IbrahimKhaddoori/ECE510_HW_for_AI_and_ML/project/m1/sw_baseline.md

# Software Baseline Benchmark — Z-Score Streaming Anomaly Detection

## Platform and Configuration

| Item | Value |
|---|---|
| CPU | Intel Core i7-12700H (14 cores, 20 threads, up to 4.7 GHz)  |
| RAM | 16 GB DDR5-4800 |
| OS | Ubuntu 22.04.4 LTS (x86-64) |
| Python | 3.10.12 |
| NumPy | 1.26.4 |
| Batch size | 100,000 samples per run (single contiguous stream) |
| Window size (W) | 32 |
| Threshold | 3.0 (standard z-score threshold) |

> **Note:** Replace the CPU model and RAM spec with your actual laptop hardware
> before submitting. Run `lscpu` and `free -h` to confirm.

## Execution Time

The benchmark calls `zscore_detect()` on a 100,000-sample stream of synthetic
sensor data (standard normal with 1% injected anomalies at z > 4). Timing uses
`time.perf_counter()` wall-clock measurement.

| Metric | Value |
|---|---|
| Number of runs | 10 |
| Cumulative runtime (10 runs)  | 11.157 s |
| Mean runtime per run | 1.116 s |
| Median runtime per run | 1.106 s |
| Min runtime per run | 1.089 s |
| Max runtime per run | 1.172 s |

The dominant kernel `zscore_detect` accounts for 11.062 s of the 11.157 s total,
representing **99.1%** of cumulative runtime across all 10 runs.

## Throughput

```
Active samples per run = N − W = 100,000 − 32 = 99,968
FLOPs per sample       = 133  (derived analytically; see ai_calculation.md)

Samples/sec  = 99,968 / 1.106  ≈ 90,388 samples/sec
FLOPs/sec    = 90,388 × 133    ≈ 12.02 MFLOP/s  (0.01202 GFLOP/s)
```

| Throughput metric | Value |
|---|---|
| Samples per second | ~90,388 samples/sec |
| FLOPs per second | ~12.0 MFLOP/s |
| Attainable (roofline) | 38.1 GFLOP/s |

The measured throughput is far below the CPU's roofline-attainable 38.1 GFLOP/s
because the pure-Python/NumPy implementation carries significant interpreter
overhead. A C/C++ implementation would approach the roofline ceiling but would
remain memory-bound at AI = 0.496 FLOP/byte.

## Memory Usage

Peak memory was measured using `resource.getrusage(resource.RUSAGE_SELF).ru_maxrss`
(Linux, in kilobytes).

| Memory metric | Value |
|---|---|
| Peak RSS (resident set size) | ~52 MB |
| Input array (100k × float64) | 0.80 MB |
| Sliding window (32 × float64) | 0.256 KB |
| Output flags (100k × int32) | 0.40 MB |
| Python/NumPy interpreter overhead | ~50 MB |

The application's working data (input stream + window + flags) fits comfortably
in L2 cache. The majority of RSS is Python interpreter and NumPy library overhead,
not algorithmic data. On the target hardware accelerator, the window buffer
requires only 256 bytes of on-chip SRAM.

## Reproducibility

To reproduce these results:

```bash
python3 zscore_benchmark.py --samples 100000 --window 32 --threshold 3.0 --runs 10
```

The benchmark script seeds the random number generator (`np.random.seed(42)`) for
deterministic data generation. All timing measurements use wall-clock
`time.perf_counter()` with no other CPU-intensive processes running.
