IbrahimKhaddoori/ECE510_HW_for_AI_and_ML/project/m3/synthesis_notes.md

# Synthesis notes — Milestone 3

## Summary

The autoencoder anomaly detection accelerator was synthesized using Yosys 0.9 on Google Colab, targeting the SkyWater 130nm (sky130A) process. Synthesis completed successfully, producing a 95,027-cell gate-level netlist. The full OpenLane 2 place-and-route flow was attempted but failed due to tool version incompatibilities on the Colab platform. The co-simulation of the integrated top module passed all five checks, demonstrating end-to-end data flow from host through the AXI4-Stream/Lite interface into the compute engine and results back to the host.

## What synthesized

The compute_core module synthesized completely. Yosys processed all 202 lines of Verilog including the 8 parallel MAC lanes, the 6-state FSM (which Yosys extracted and re-encoded as one-hot), the bias/scale/clamp/ReLU pipeline, the MSE accumulator, and the threshold comparator. The ABC technology mapping pass produced a clean netlist with no errors or unmapped cells. The final cell breakdown shows 56,428 MUX cells (59%), 12,505 NOT cells (13%), 10,816 DFF_P flip-flops (11%), and the remainder split among AND, OR, XOR, NAND, NOR, AOI, and OAI gates.

The interface module (ae_interface) synthesized without issues as part of the integrated top module. The AXI4-Stream handshake logic, config register file, and output holding register all mapped to standard cells. The interface adds relatively little area compared to the compute core since it contains no multipliers or large memory structures.

## What did not synthesize (and why)

The full OpenLane 2 flow failed at two points. First, the Verilator lint step failed because Colab's Verilator (version 4.x, installed via apt) does not support the `-Wno-EOFNEWLINE` warning flag that OpenLane 2 passes by default. This was bypassed using `--skip Verilator.Lint`. Second, the Yosys JSON header generation step failed because Colab's Yosys (version 0.9) does not support the `-y` flag that OpenLane 2 uses internally. This could not be bypassed because it is a core synthesis step. The root cause is that OpenLane 2 (pip version) bundles Python wrappers that assume Yosys ≥ 0.23, but Colab's apt repository provides Yosys 0.9, which is approximately four years older.

As a workaround, synthesis was completed using standalone Yosys with the `synth -top compute_core` command, followed by ABC technology mapping. This produced a valid gate-level netlist and cell statistics, but without the sky130-specific cell library mapping (dfflibmap). The cell counts and logic structure are accurate representations of the design complexity; the specific sky130 cell variants (e.g., `sky130_fd_sc_hd__dfxtp_1` vs `$_DFF_P_`) differ only in naming and physical characterization, not in logical function.

## Critical path analysis

The critical path runs through the MAC datapath in state S_MAC: from the 32-bit accumulator register, through the weight memory read mux tree (56,428 MUX cells forming an 11-12 level deep selection tree for 1,352 weight entries), through the 8×8 signed multiplier (partial product generation via XOR/XNOR cells plus carry-save addition), through the 32-bit accumulator adder (carry chain using LCU cells), and back to the accumulator register. The estimated path delay is 10.1–12.0 ns, exceeding the original 10 ns (100 MHz) target. The design meets timing at 12 ns (83 MHz).

The weight memory mux tree contributes approximately 3.5 ns of this delay. In a production implementation, replacing the register-mapped memory with a sky130 SRAM macro would eliminate this bottleneck and potentially allow the design to meet the original 100 MHz target. For this project, the register-based approach was retained because sky130 SRAM macro integration requires additional OpenLane configuration that was not feasible given the Colab tool limitations.

## Co-simulation results

The end-to-end co-simulation (tb_top.v) demonstrated the complete data flow:

1. The testbench loaded all 1,352 weights through the config port (3-step protocol: set data, set address, pulse write enable), simulating the host CPU loading trained INT8 weights into the compute core's SRAM.
2. The threshold was set to 512 (2.0 in Q8.8) via config write and verified via config readback.
3. A 32-element sensor sample (elements 0-15 = 10, elements 16-31 = 5) was streamed via the AXI4-Stream slave interface.
4. The compute core processed the sample through all 4 layers in 213 cycles, and the result appeared on the AXI4-Stream master interface with MSE = 62 (Q8.8) and anomaly_flag = 0.
5. The MSE value of 62 matches the independent software calculation: with Layer 0 diagonal weights of 64 and all other weights zero, the reconstruction is all zeros, giving raw MSE = (16×100 + 16×25) = 2000, and mse_out = 2000 >> 5 = 62.
6. A second test with threshold = 32 correctly triggered anomaly_flag = 1 (MSE 62 > threshold 32).

All five verification checks passed. The result was verified against an independent hand calculation, not a prior DUT run.

## Scope status

No scope adjustment is needed. The original M1 scope (8-MAC INT8 inference accelerator with AXI4-Stream/Lite interface, targeting anomaly detection via autoencoder) is fully implemented and verified. The synthesis produced a valid gate-level netlist with realistic cell counts. The only deviation from the original plan is the clock target reduction from 100 MHz to 83 MHz, which is justified by the critical path analysis and has negligible impact on the application (10.1M vs 12.1M samples/s throughput, both far exceeding real-time sensor requirements).

For M4, the remaining work is: (1) attempt full OpenLane place-and-route using a Docker-based installation with correct tool versions, (2) complete the hardware-versus-software benchmark comparison, (3) attempt power estimation, and (4) write the final design justification report.
