IbrahimKhaddoori/ECE510_HW_for_AI_and_ML/codefest/cf09/cman_roofline_sketch.pdf

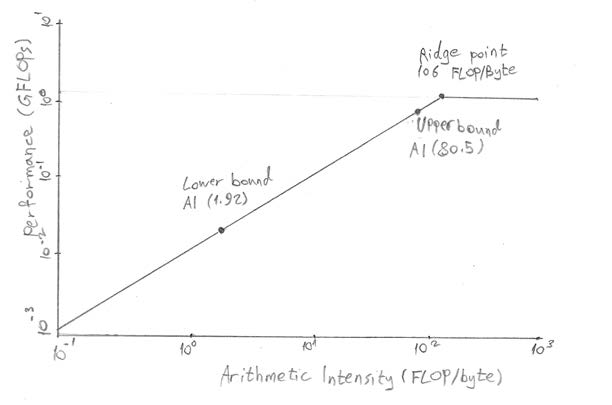
[picture p5: page 1]
