IbrahimKhaddoori/ECE510_HW_for_AI_and_ML/codefest/cf09/cman_ai_analysis.pdf

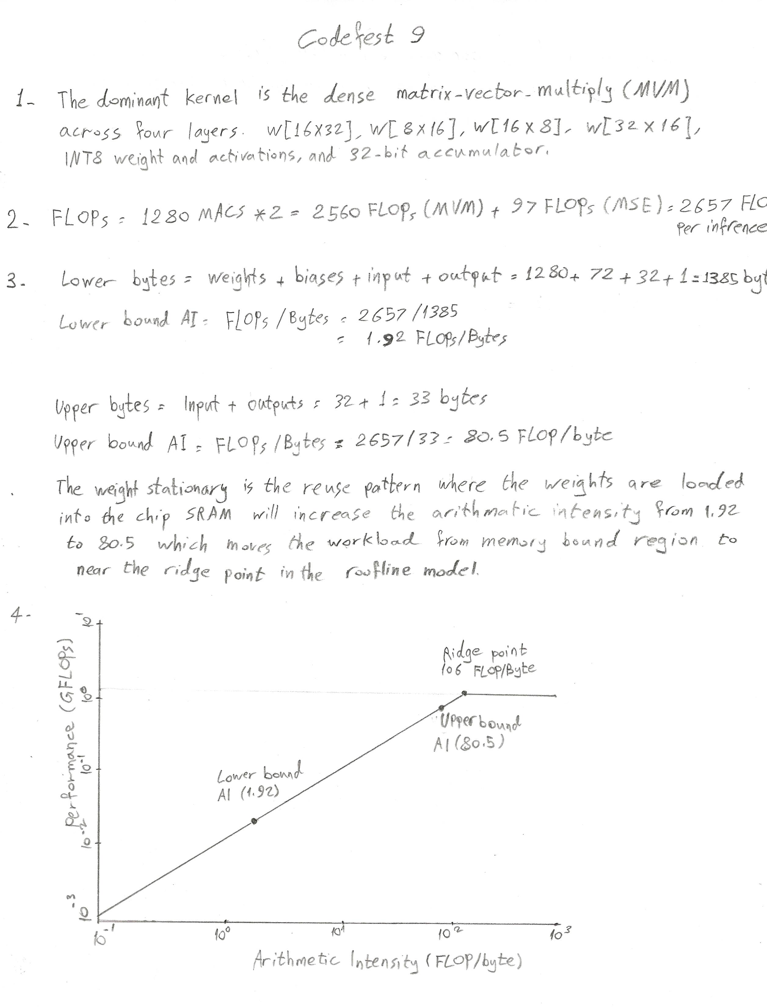
[picture p6: page 1]
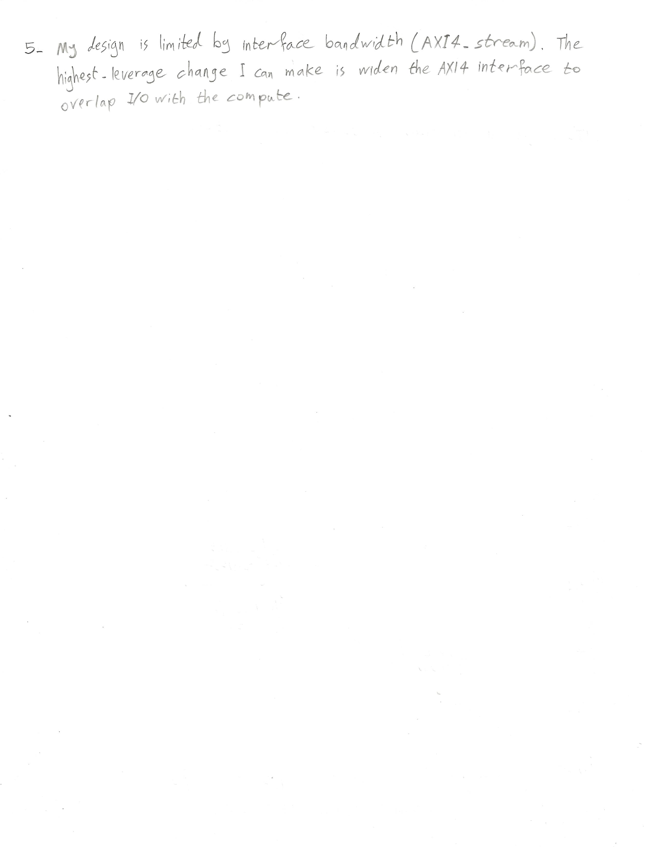
[picture p7: page 2]
