IbrahimKhaddoori/ECE510_HW_for_AI_and_ML/codefest/cf08/cman_aer_analysis.pdf

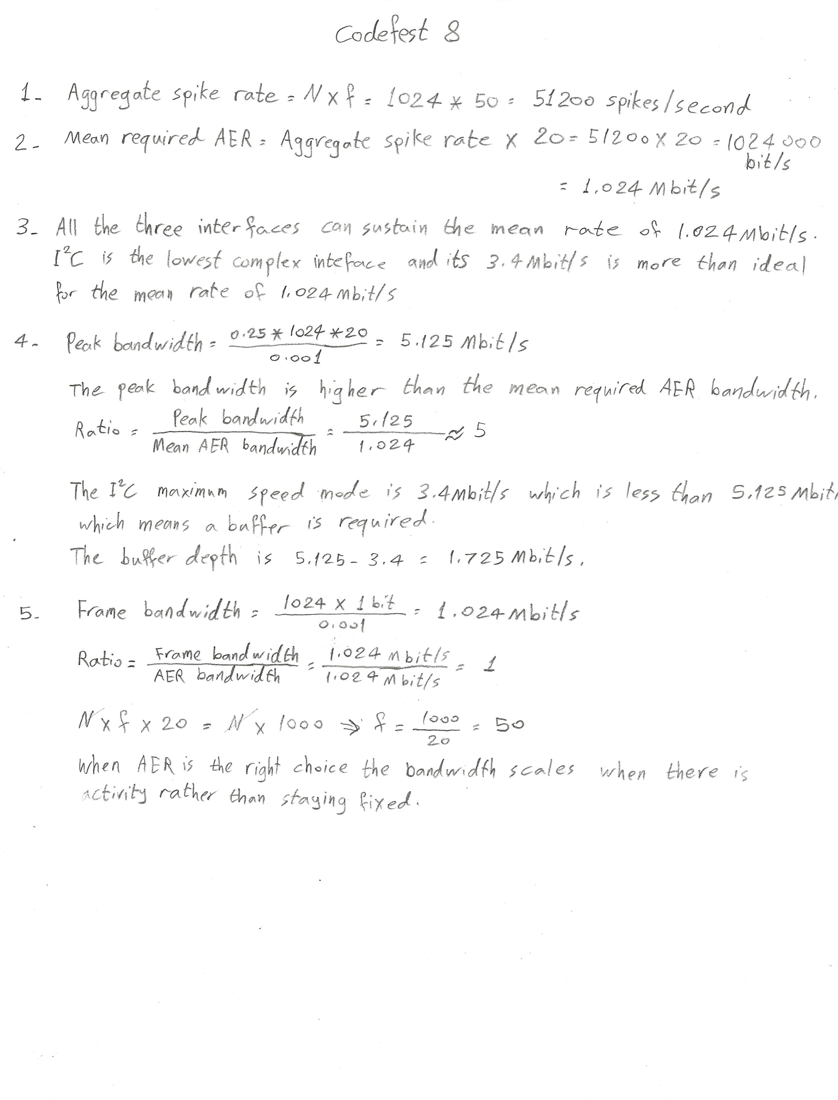
[picture p8: page 1]
