IbrahimKhaddoori/ECE510_HW_for_AI_and_ML/codefest/cf07/cman_sparsity_analysis.pdf

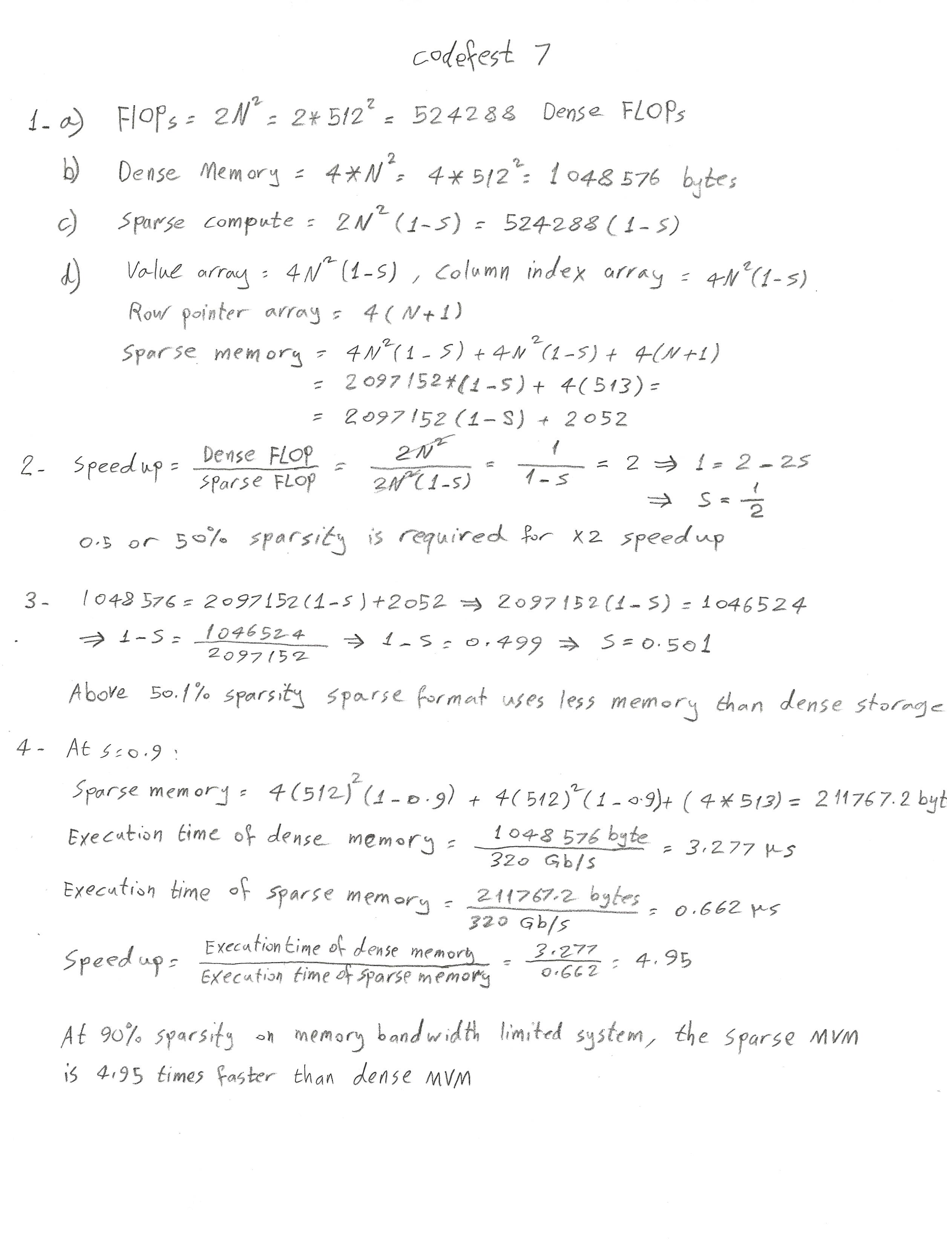
[picture p9: page 1]
