IbrahimKhaddoori/ECE510_HW_for_AI_and_ML/codefest/cf06/cman_sneak_path.pdf

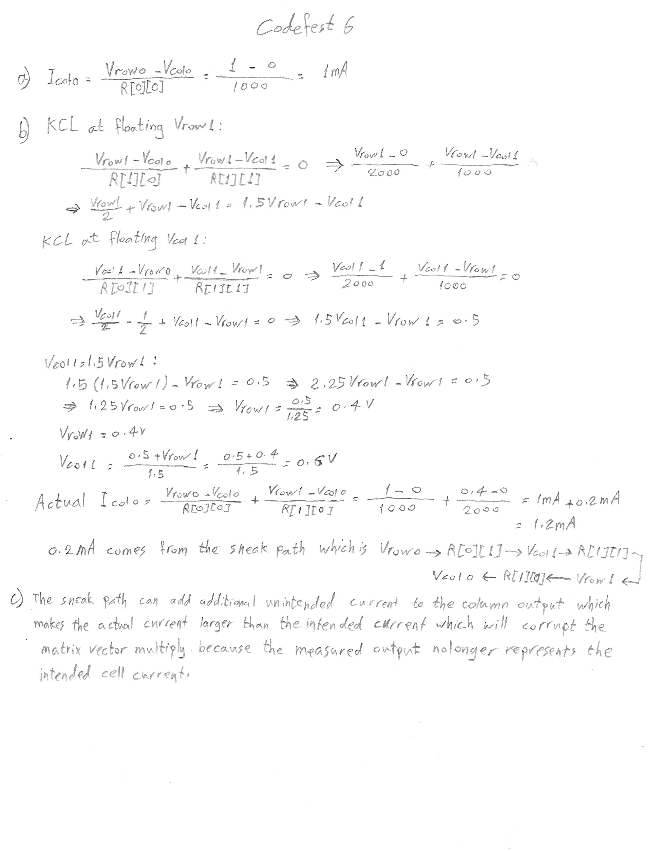
[picture p10: page 1]
