IbrahimKhaddoori/ECE510_HW_for_AI_and_ML/codefest/cf05/cman_systolic_trace.pdf

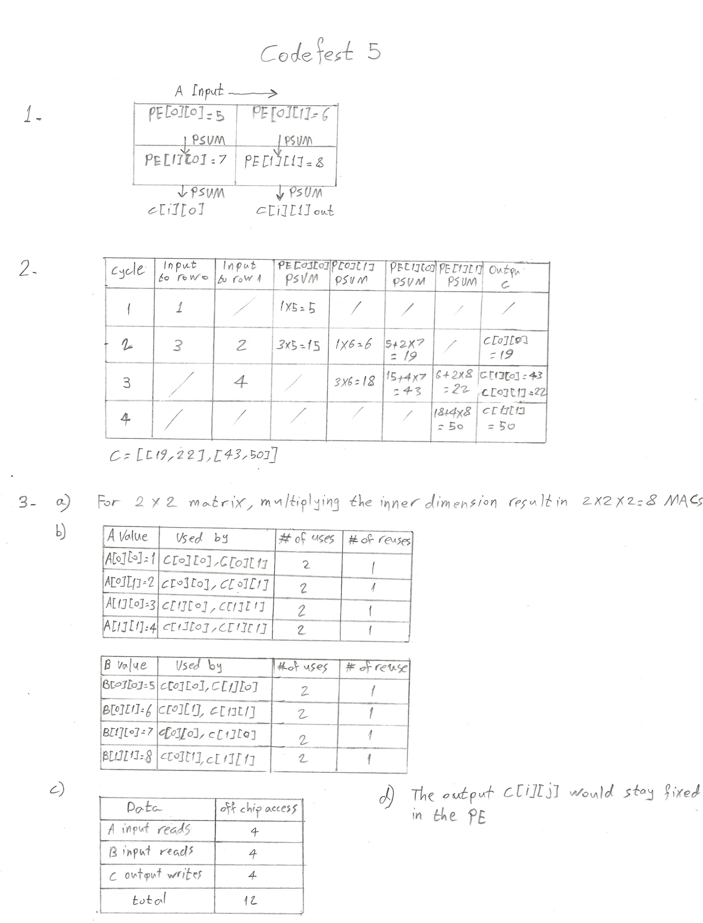
[picture p11: page 1]
