IbrahimKhaddoori/ECE510_HW_for_AI_and_ML/codefest/cf04/cman_quantization.pdf

## CF04 : Cman Quantization

Original Weight Matrix W (FP32):

| Col 0 | Col 1 | Col 2 | Col 3
Row 0 | 0.85 | -1.20 | 0.34 | 2.10
Row 1 | -0.07 | 0.91 | -1.88 | 0.12
Row 2 | 1.55 | 0.03 | -0.44 | -2.31
Row 3 | -0.18 | 1.03 | 0.77 | 0.55

### 1) Scale Factor S

Formula: S = max(|W|) / 127

maximum(|W|) = 2.31 at position (2,3)

S = 2.31 / 127 = 0.018

### 2) Quantize

W_q = round(W / S), clamped to [−128, 127]:

Col 0 Col 1 Col 2 Col 3

Row 0 47 | -66 | 19 | 115
Row 1 -4 | 50 | -103 | 7
Row 2 85 | 2 | -24 | -127
Row 3 -10 | 57 | 42 | 30

### 3) Dequantize

W_deq = W_q x S:

Col 0 | Col 1 | Col 2 | Col 3

Row 0 0.8549 -1.2005 0.3456 2.0917

Row 1 -0.0728 0.9094 -1.8735 0.1273

Row 2 1.5461 0.0364 -0.4365 -2.3100

Row 3 -0.1819 1.0368 0.7639 0.5457

### 4) Error Analysis

Per-element absolute error |W − W_deq|:

Col 0 | Col 1 | Col 2 | Col 3

Row 0 0.004882 0.000472 0.005591 0.008268

Row 1 0.002756 0.000551 0.006536 0.007323

Row 2 0.003937 0.006378 0.003465 0

Row 3 0.001890 0.006772 0.006063 0.004331

Largest error: 0.008268 at position (0,3) W = 2.10, W_deq = 2.0917

Mean Absolute Error (MAE): (0.004882 + 0.000472 + 0.005591 + 0.008268 + 0.002756 + 0.000551 + 0.006536 + 0.007323 + 0.003937 + 0.006378 + 0.003465 + 0 + 0.001890 + 0.006772 + 0.006063 + 0.004331) / 16 = 0.004326

### 5) Bad Scale Experiment

With S_bad = 0.01, clamped to [−1.28, 1.27].

Quantized and clamping to [−128, 127]):

Col 0 Col 1 Col 2 Col 3

Row 0 85 | -120 | 34 | 127
Row 1 -7 | 91 | -128 | 12
Row 2 127 | 3 | -44 | -128
Row 3 -18 | 103 | 77 | 55

Dequantized:

Col 0 Col 1 Col 2 Col 3

Row 0 0.85 | -1.20 0.34 | 1.27
Row 1 -0.07 0.91 | -1.28 0.12
Row 2 1.27 | 0.03 | -0.44 -1.28
Row 3 -0.18 1.03 | 0.77 | 0.55

MAE_bad = (0.83 + 0.28 + 0.6 + 1.03) / 16 = 0.1713

When S is too small, the quantized range will not include values with magnitude larger than 1.28 and smaller than -1.27, which make the values clamp to the INT8 boundary, causing severe clipping error on large weights that fall outside the range resulting in a large mean absolute error.
