IbrahimKhaddoori/ECE510_HW_for_AI_and_ML/codefest/cf03/cman_dram_traffic.pdf

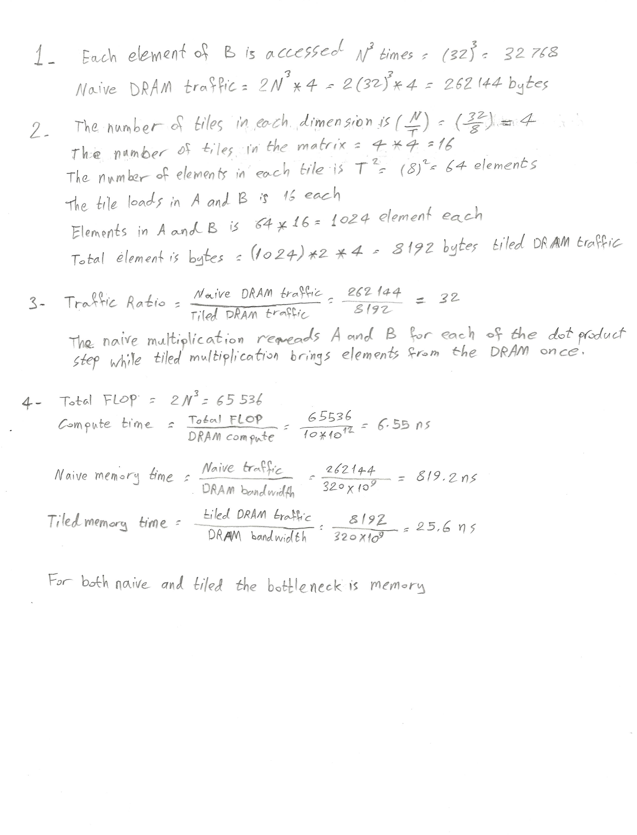
[picture p12: page 1]
