IbrahimKhaddoori/ECE510_HW_for_AI_and_ML/codefest/cf02/cman_roofline.pdf

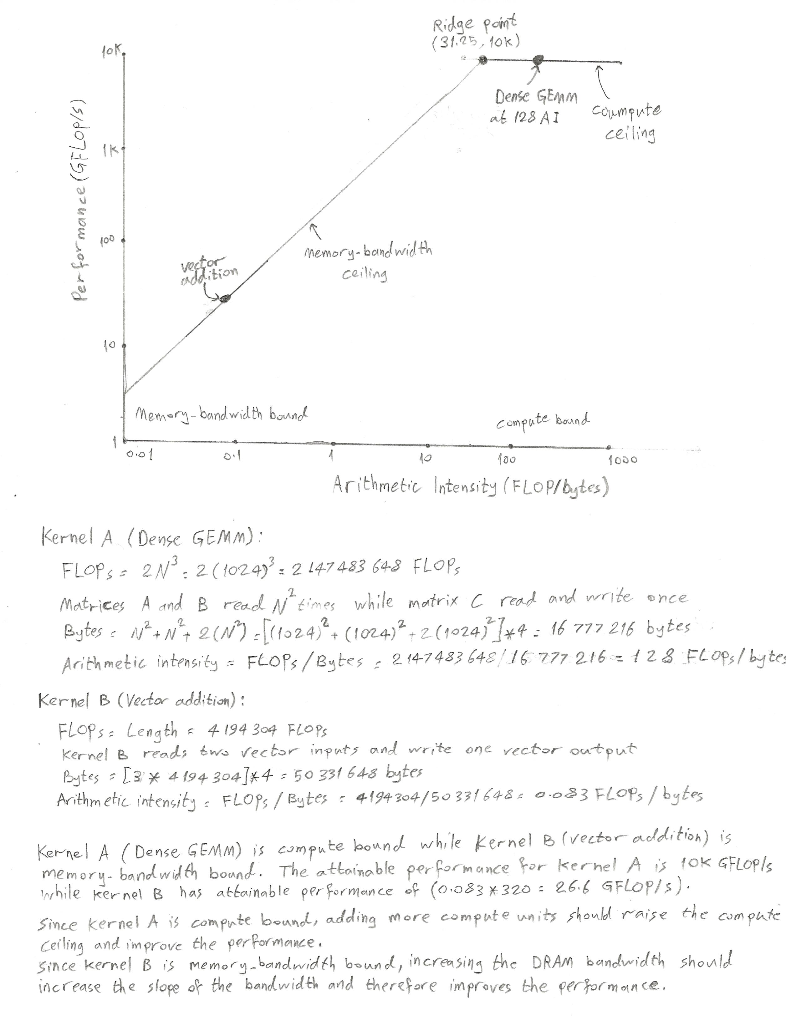
[picture p13: page 1]
