IbrahimKhaddoori/ECE510_HW_for_AI_and_ML/project/m3/synth/timing_report.txt

# Static Timing Analysis — Estimate Report
# Design: compute_core
# Clock:  clk (target period = 10.0 ns, 100 MHz)
# PDK:    sky130A (SkyWater 130nm)
# Tool:   Yosys 0.9 synthesis + manual critical path analysis
# Note:   Full STA (OpenSTA) could not run on Colab due to Yosys/OpenLane
#         version incompatibility. This report is derived from the synthesized
#         netlist structure and sky130 cell delay estimates.
# ============================================================================

Clock: clk
  Period:          10.0 ns
  Frequency:       100 MHz

# ----------------------------------------------------------------------------
# Critical Path Analysis
# ----------------------------------------------------------------------------

Path 1 (WORST CASE — Setup):
  Startpoint:  acc0[31:0]  (DFF_P, rising edge of clk)
  Endpoint:    acc0[31:0]  (DFF_P, rising edge of clk)
  Path Group:  clk
  Path Type:   max (setup)

  Description:
    The critical path runs through the MAC datapath in state S_MAC:
      1. acc register output        →  ~0.3 ns  (clk-to-Q of $_DFF_P_)
      2. weight_mem read mux tree   →  ~3.5 ns  (56,428 MUX cells, ~12 levels deep
                                                   for 1352-entry memory)
      3. 8x8 signed multiplier      →  ~2.5 ns  (XOR/AND/adder tree for
                                                   partial products, 2430 XOR +
                                                   1143 XNOR cells)
      4. 32-bit accumulator add     →  ~3.0 ns  (carry chain through 32-bit
                                                   ripple/LCU adder)
      5. MUX for state-dependent    →  ~0.5 ns  (select between MAC result
         writeback                                and other state outputs)
      6. DFF setup time             →  ~0.3 ns

  Estimated Path Delay:    ~10.1 - 12.0 ns
  Required Time:           10.0 ns (clock period) - 0.3 ns (setup) = 9.7 ns
  Estimated Worst Slack:   -0.4 to -2.3 ns  (VIOLATED)
  Estimated Max Frequency: 83 - 100 MHz

# ----------------------------------------------------------------------------
# Path 2 (MSE Datapath):
# ----------------------------------------------------------------------------

Path 2:
  Startpoint:  orig_in[*] / act_out[*]  (DFF_P)
  Endpoint:    mse_acc[31:0]            (DFF_P)

  Description:
    MSE computation in state S_MSE:
      1. Read orig_in[mse_idx] and act_out[mse_idx] from register files
      2. 9-bit subtraction (mse_diff)
      3. 18-bit squaring (mse_diff * mse_diff)
      4. 32-bit accumulate (mse_acc + mse_sq)

  Estimated Path Delay:    ~8.0 ns
  Slack:                   ~+1.7 ns (MET)

# ----------------------------------------------------------------------------
# Path 3 (Weight Address Computation):
# ----------------------------------------------------------------------------

Path 3:
  Startpoint:  cur_round / cur_layer  (DFF_PN0)
  Endpoint:    weight_mem read address (combinational to MUX select)

  Description:
    Address calculation: l_wbase + (nbase + offset) * l_in + mac_idx
    Involves two multiplications and two additions feeding the mux tree.

  Estimated Path Delay:    ~7.0 ns
  Slack:                   ~+2.7 ns (MET)

# ----------------------------------------------------------------------------
# Summary
# ----------------------------------------------------------------------------

  Worst Negative Slack (WNS):     -0.4 to -2.3 ns (estimated)
  Total Negative Slack (TNS):     -50 to -200 ns (estimated, ~80 endpoints)
  Number of Violating Paths:      ~80 (accumulator register bits)
  Number of Paths Analyzed:       ~11,902 (all flip-flop endpoints)

  Recommendation:
    - Relax clock to 12.0 ns (83 MHz) to meet timing with positive slack
    - Or pipeline the MAC: split multiply and accumulate into 2 stages
    - Weight memory mux tree is a secondary concern (contributes ~3.5 ns)
      but would be eliminated by using an SRAM macro

# ============================================================================
# Cell Area Estimates (sky130_fd_sc_hd)
# ============================================================================
#
# Cell Type          Count    Est. Area/Cell (um²)   Total Area (um²)
# $_DFF_P_           10,816   ~21.5                  ~232,544
# $_DFF_PN0_          1,085   ~26.3                  ~ 28,536
# $_MUX_             56,428   ~11.3                  ~637,636
# $_NOT_             12,505   ~ 3.8                  ~ 47,519
# $_OR_               4,081   ~ 5.1                  ~ 20,813
# $_ANDNOT_           2,738   ~ 5.1                  ~ 13,964
# $_XOR_              2,430   ~ 8.8                  ~ 21,384
# $_XNOR_             1,143   ~ 8.8                  ~ 10,058
# Other               3,801   ~ 7.0 (avg)            ~ 26,607
# ─────────────────────────────────────────────────────────────
# TOTAL              95,027                           ~1,039,061 um²
#
# Die area (config):  1400 x 1400 = 1,960,000 um²
# Core utilization:   ~53%
# ============================================================================
