IbrahimKhaddoori/ECE510_HW_for_AI_and_ML/codefest/cf02/profiling/roofline_project.png

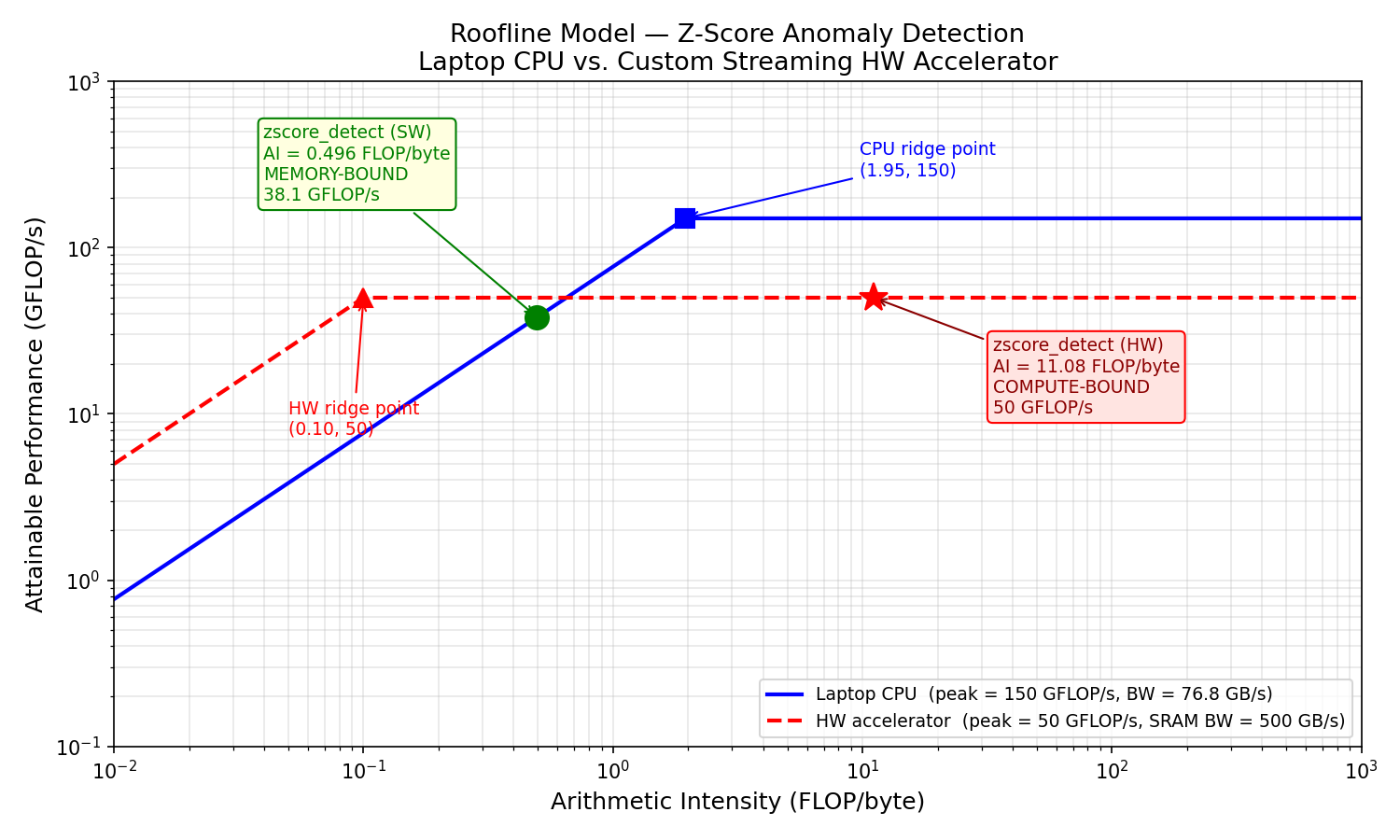
codefest/cf02/profiling/roofline_project.png
