IbrahimKhaddoori/ECE510_HW_for_AI_and_ML/codefest/cf03/profiling/gemm_roofline.png

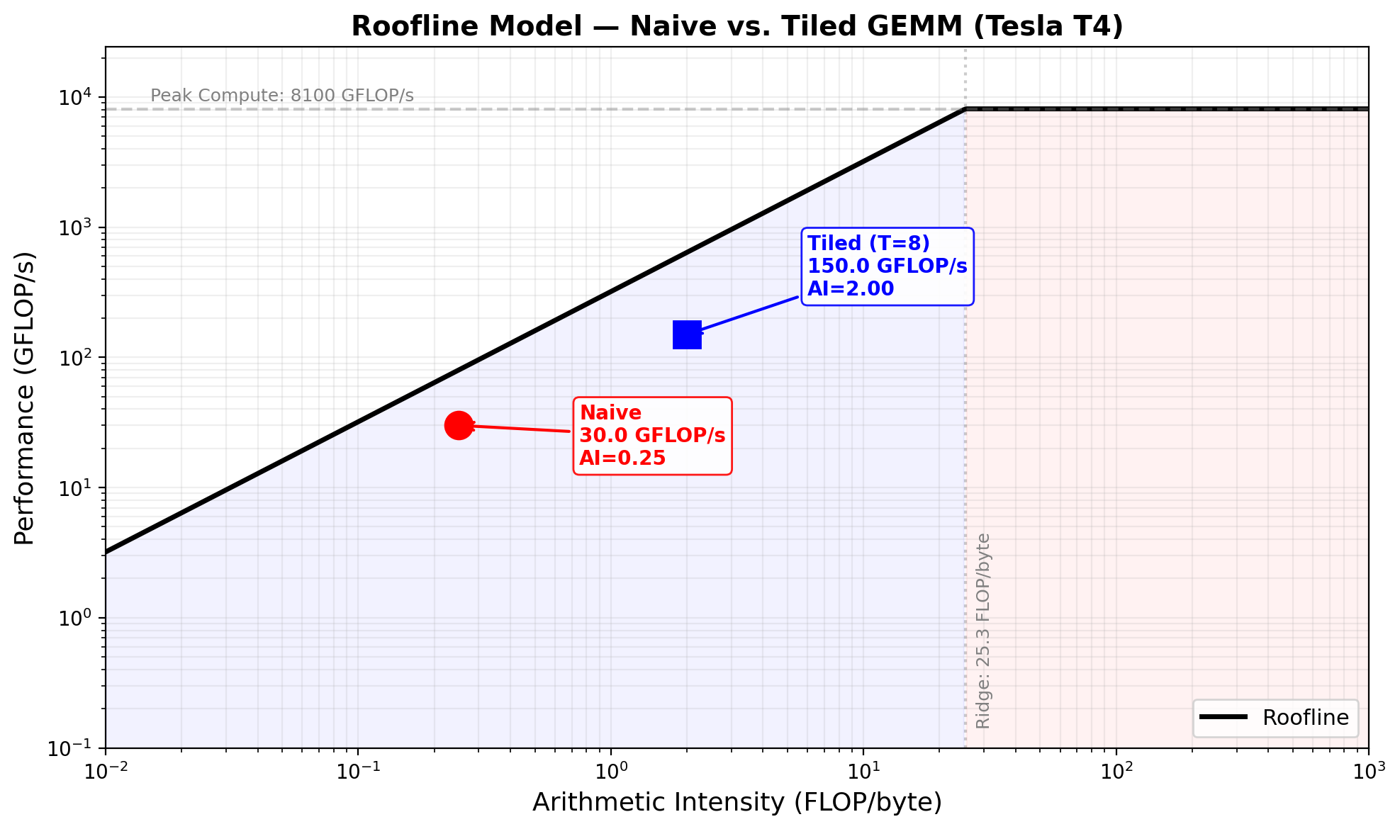
codefest/cf03/profiling/gemm_roofline.png
