IbrahimKhaddoori/ECE510_HW_for_AI_and_ML/project/algorithm_diagram.png

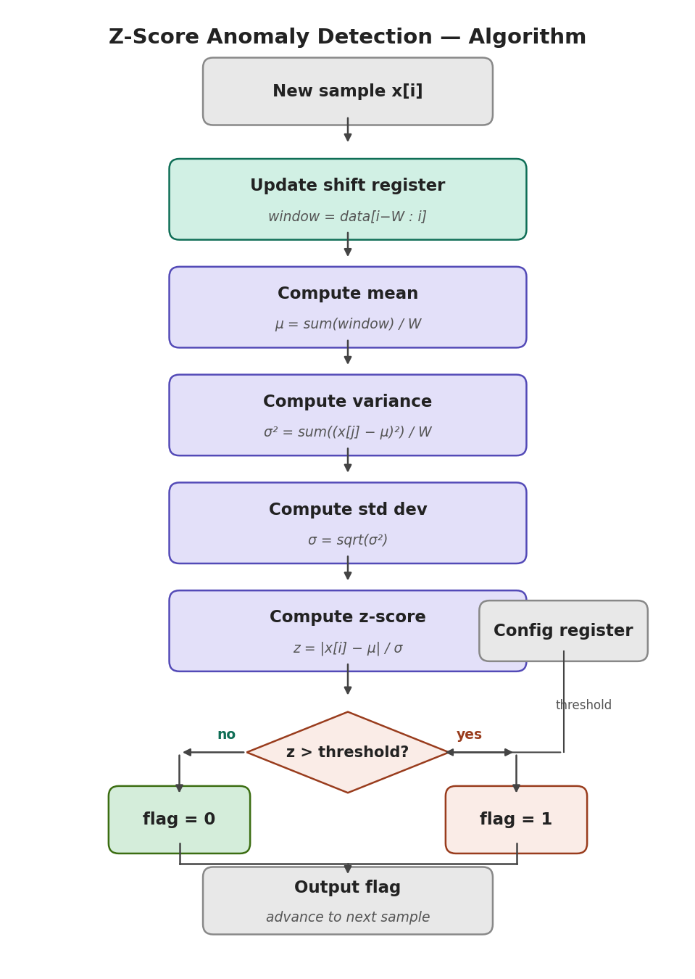
project/algorithm_diagram.png
