IbrahimKhaddoori/ECE510_HW_for_AI_and_ML/project/m1/system_diagram.png

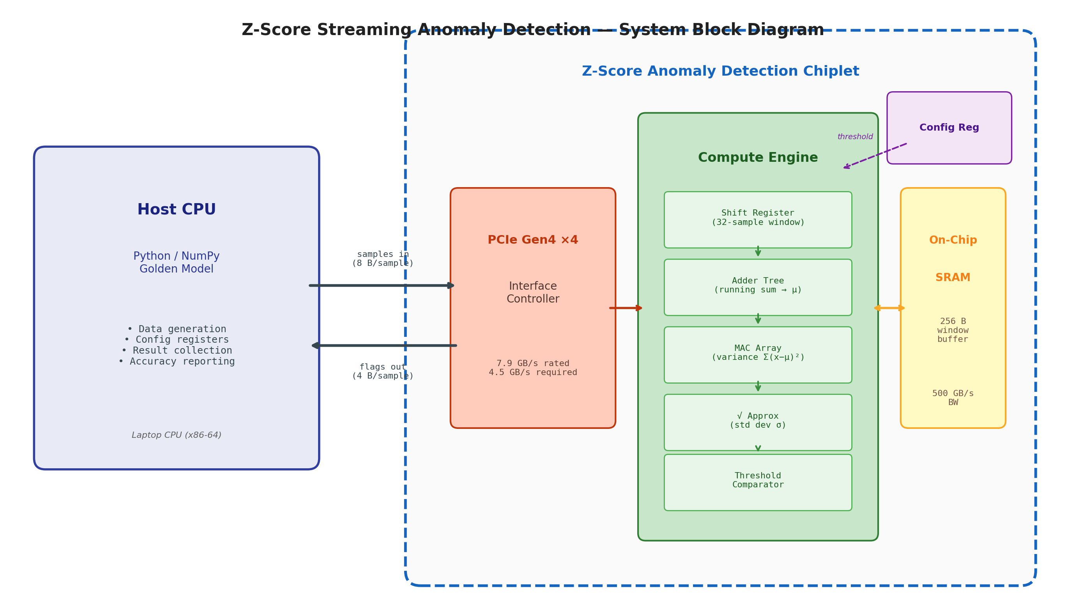
project/m1/system_diagram.png
