IbrahimKhaddoori/ECE510_HW_for_AI_and_ML/project/m2/sim/waveform.png

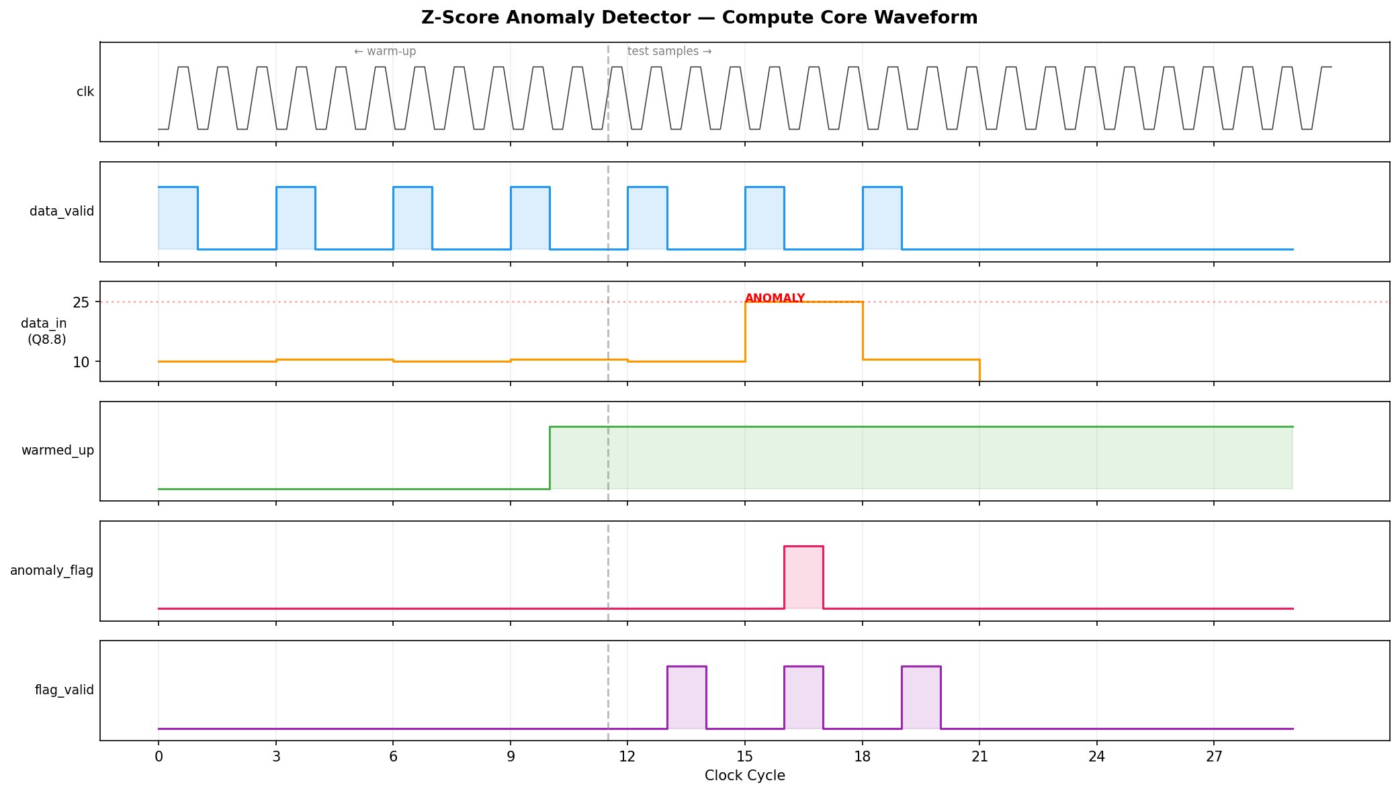
project/m2/sim/waveform.png
