IbrahimKhaddoori/ECE510_HW_for_AI_and_ML/project/m3/sim/cosim_waveform.png

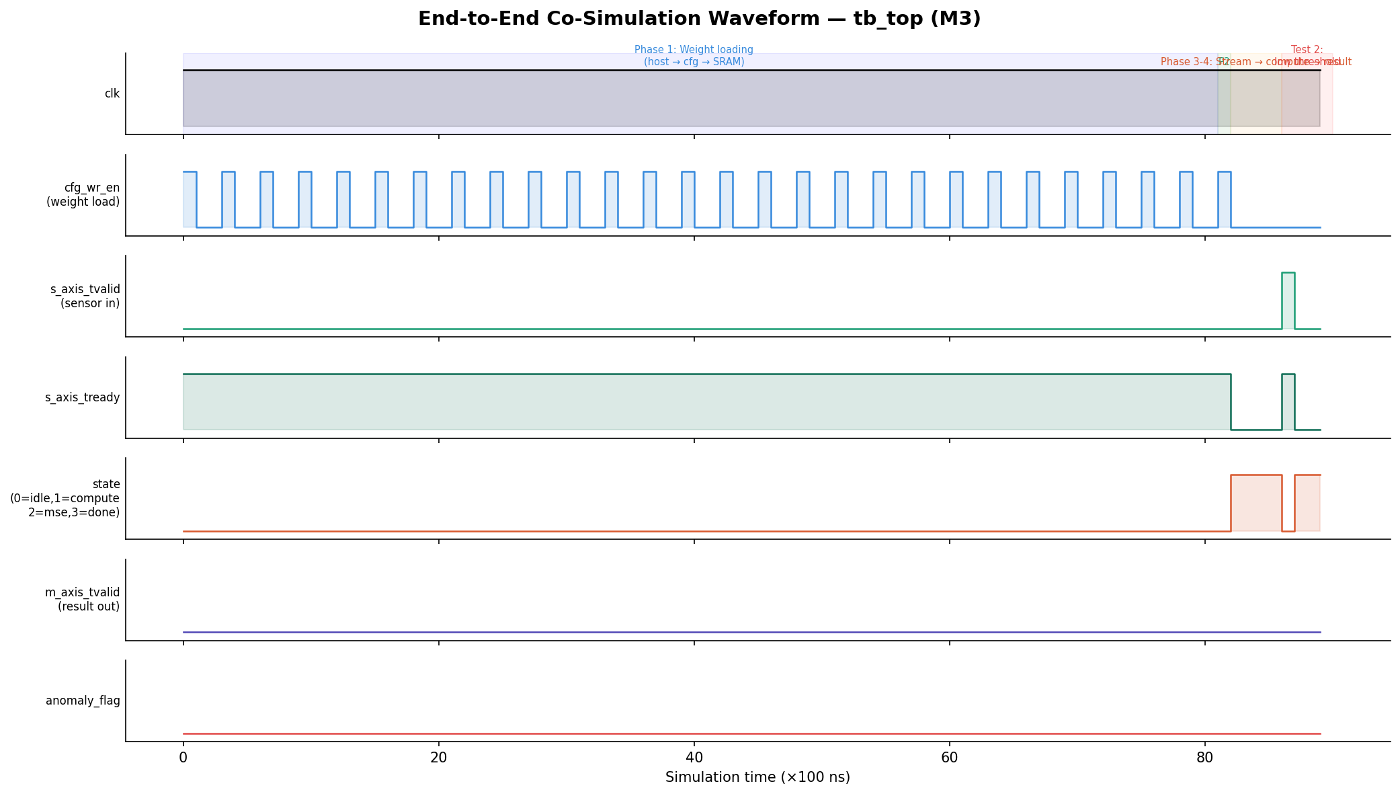
project/m3/sim/cosim_waveform.png
