IbrahimKhaddoori/ECE510_HW_for_AI_and_ML/project/m4/report/fig1_block_diagram.png

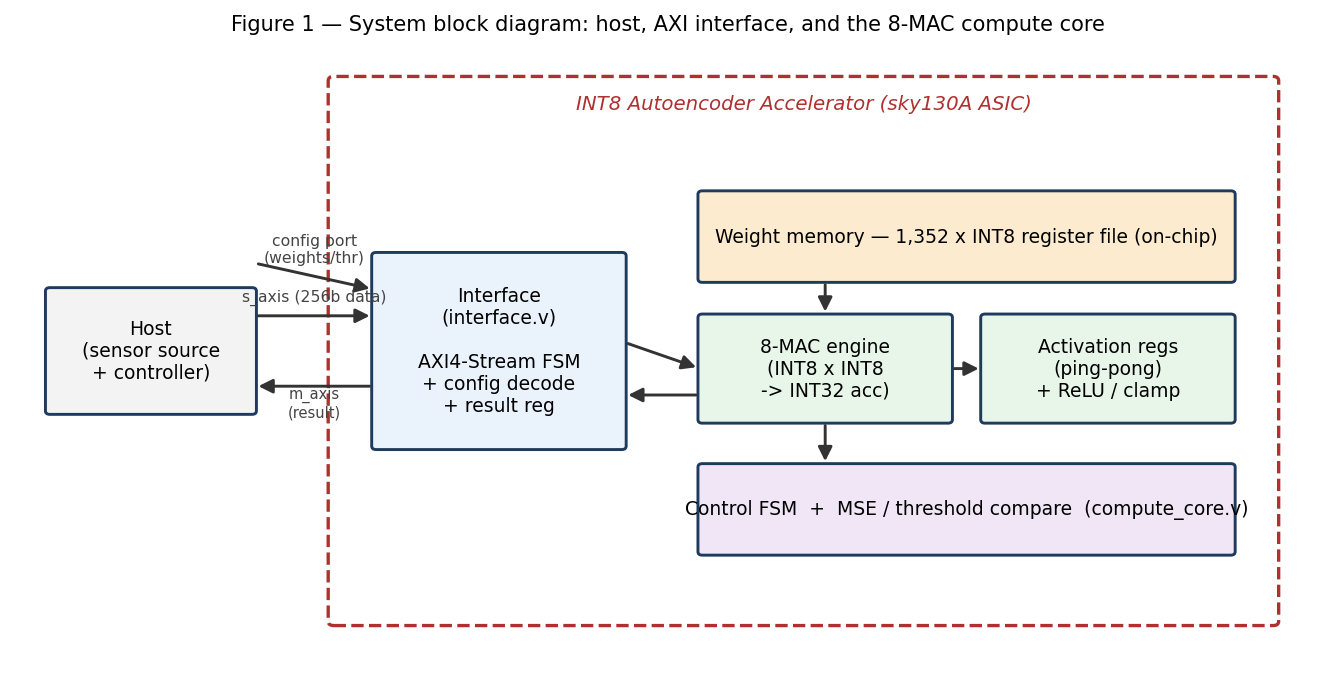
project/m4/report/fig1_block_diagram.png
