IbrahimKhaddoori/ECE510_HW_for_AI_and_ML/codefest/cf09/benchmarks/roofline_plot.png

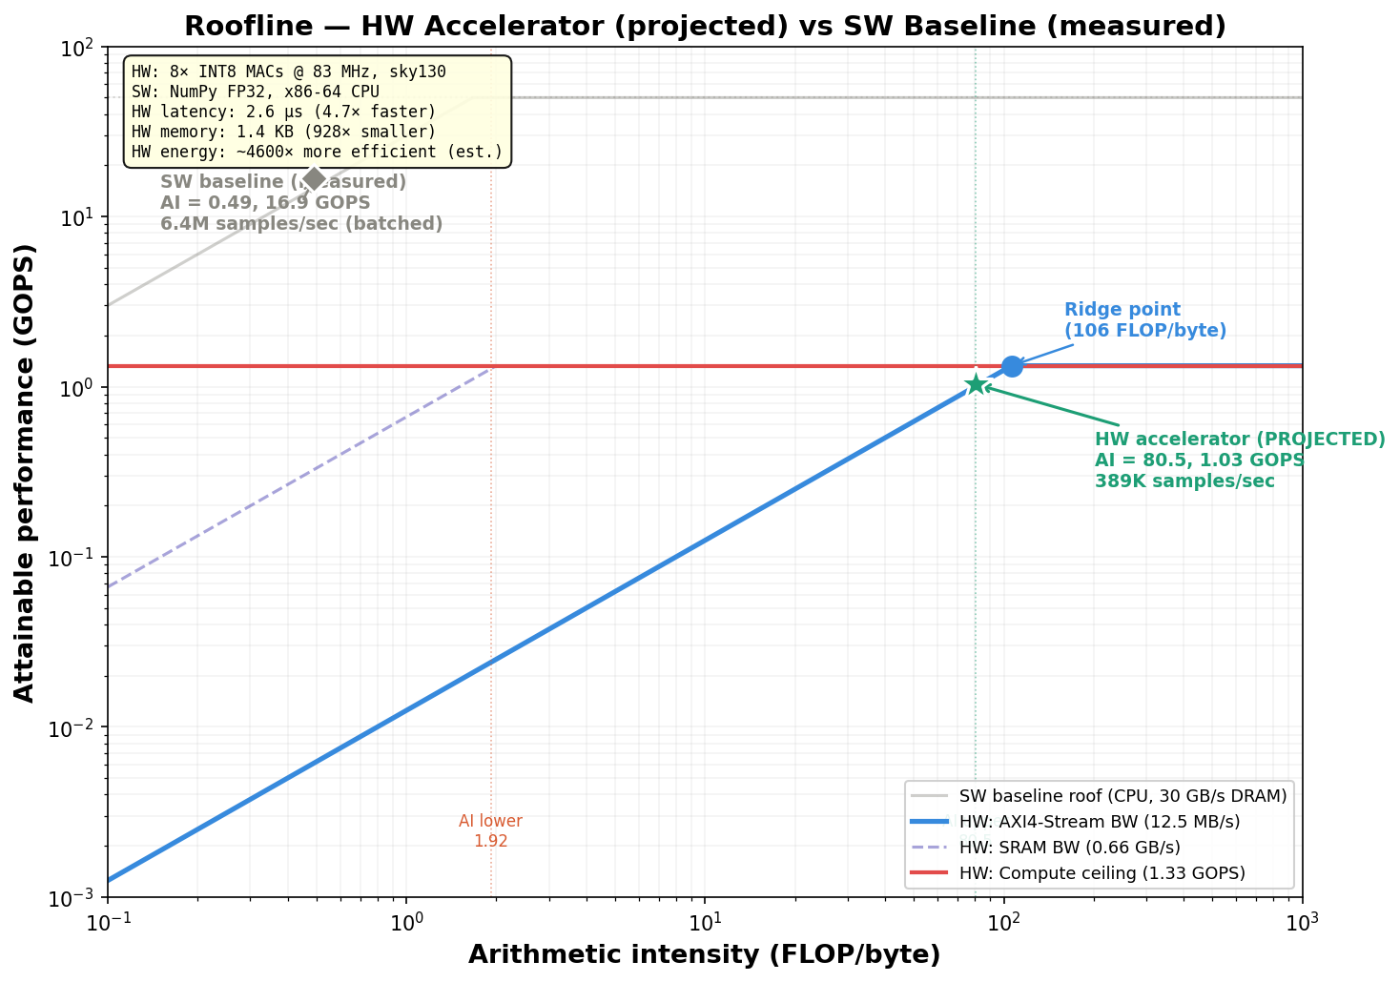
codefest/cf09/benchmarks/roofline_plot.png
